agteo/diy-eeg-mac/Manufacturing/JLCPCB/BOM_JLCPCB_EEG.csv

Comment | Designator | Footprint | LCSC Part #
0.47uF 25V X7R 0603 | C1 | 0603 | C1623
4.7uF 25V X5R 0805 | C2,C3,C48 | 0805 | C1779
4.7uF 25V X5R 0805 | C49 | 0805 | C1779
2.2uF 25V X7R 0805 | C4,C5 | 0805 | C19110
10uF 25V X5R 0805 | C6,C7,C9,C12,C33 | 0805 | C15850
1uF 50V X5R 0603 | C10,C11,C35,C36,C38,C39,C40,C43,C44,C46 | 0603 | C15849
100nF 50V X7R 0603 | C13,C32,C37,C41,C42,C45,C47 | 0603 | C14663
1.5nF 50V C0G 5% 0603 | C14 | 0603 | C107039
1nF 50V C0G 1% 0603 | C15,C16,C17,C18,C19,C20,C21,C22,C23,C24,C25,C26,C27,C28,C29,C30,C31 | 0603 | C309468
100uF 6.3V X5R 1206 | C34 | 1206 | C15008
TPD4E1B06DCKR | D1,D2,D3,D4,D5 | SC-70-6 | C840093
SD05T1G | D6 | SOD-323 | C233423
ESD 5V uni TVS SOD-523 | D7 | SOD-523 | C136171
JST PH 2-pin side-entry | J1 | JST-PH-2P-RA-THT | C173752
USB-C receptacle USB2.0 16P | J2 | USB-C-SMD | C3197684
Pin header 1x2 2.54mm straight | J3A,J3B,J3C,J3D,J3E,J3F,J3G,J3H,J3I,J3J,JP1 | HDR-1x2-2.54-THT | C32713268
Pin header 1x3 2.54mm straight | J5 | HDR-1x3-2.54-THT | C6292175
130k 0.1% 25ppm thin film 0603 | R1 | 0603 | C855601
120k 0.1% 25ppm thin film 0603 | R2 | 0603 | C705720
105k 0.1% 25ppm thin film 0603 | R3 | 0603 | C861072
100k 0.1% 25ppm thin film 0603 | R4 | 0603 | C855559
5.1k 1% 0603 | R5,R6 | 0603 | C23186
10k 1% 0603 | R7,R8,R28,R29,R30,R31 | 0603 | C25804
10k 1% 0603 | R32,R33,R34,R35 | 0603 | C25804
1M 1% 0603 | R9 | 0603 | C22935
2.2k 0.1% 25ppm thin film 0603 | R10,R11,R12,R13,R14,R15,R16,R17,R18,R19,R20,R21,R22,R23,R24,R25,R26,R27 | 0603 | C861295
Slide switch SPDT | SW1 | C&K-1101M2S3CQE2-THT | C221538
Tactile switch 4.5mm SMD J-lead | SW2,SW3 | Bourns-7914J | C913243
Test point orange THT | TP1 | Keystone-5003-THT | C238124
LM27762DSSR | U1 | WSON-12-EP(2x3) | C473398
TLV75733PDBVR | U2 | SOT-23-5 | C485517
TPS7A2033PDBVR | U3 | SOT-23-5 | C2862740
ADS1299IPAGR | U4 | TQFP-64(10x10) | C476817
ESP32-S3-WROOM-1-N8R8 | U5 | ESP32-S3-WROOM-1 | C2913201
