agteo/diy-eeg-mac/Hardware/Enclosure_Inventor_Project/Enclosure_Top.stp

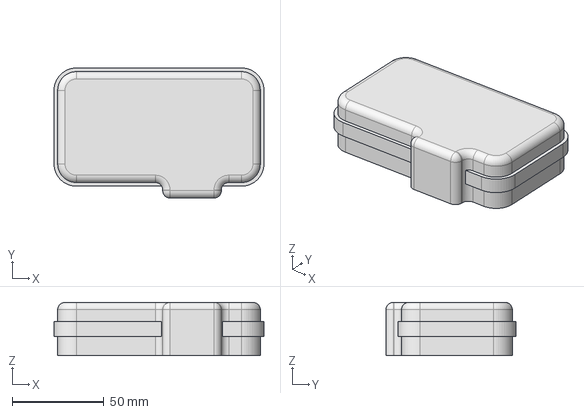
[picture p6: CAD file, 2026-10-10]
Hardware/Enclosure_Inventor_Project/Enclosure_Top.stp
114.4 x 70.9 x 29.0 mm
