agteo/diy-eeg-mac/Production_Files/Enclosure STL Files/Enclosure Bottom.stl

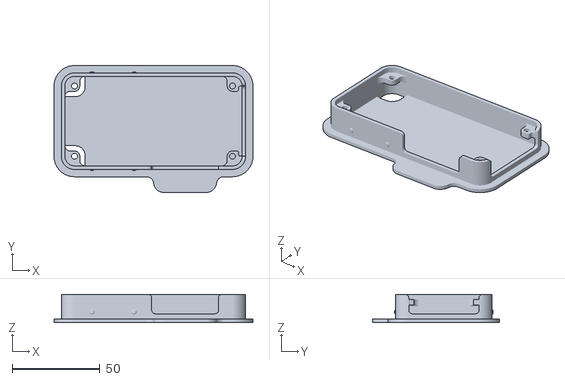
[picture p7: CAD file, 2026-10-10]
Production_Files/Enclosure STL Files/Enclosure Bottom.stl
113.4 x 72.4 x 16.0
