agteo/diy-eeg-mac/(list of files, cad)

Other CAD files:
Hardware/Enclosure_Inventor_Project/Enclosure Bottom.stp
Production_Files/Enclosure STL Files/Enclosure_Top.stl
Hardware/Enclosure_Inventor_Project/Enclosure Bottom.ipt
Hardware/Enclosure_Inventor_Project/Enclosure_Multibody.ipt
Hardware/Enclosure_Inventor_Project/Enclosure_Top.ipt
Hardware/Enclosure_Inventor_Project/OldVersions/Enclosure Bottom.0002.ipt
Hardware/Enclosure_Inventor_Project/OldVersions/Enclosure_Top.0003.ipt
