agteo/diy-eeg-mac/(list of files, drawings)

Other design files:
Hardware/PCB_Altium_Project/Component Libraries/ESP32-S3-WROOM-1-N8R8/ESP32-S3-WROOM-1-N8R8.SchLib
Hardware/PCB_Altium_Project/Component Libraries/ESP32-S3-WROOM-1-N8R8/XCVR_ESP32S3WROOM1N8R8.PcbLib
Hardware/PCB_Altium_Project/DIY-EEG.PrjPcb
Hardware/PCB_Altium_Project/EEG_PCB.PcbDoc
Hardware/PCB_Altium_Project/EEG_Schematic.SchDoc
Hardware/PCB_Altium_Project/Low_Cost_EEG.PrjPcb
