agteo/diy-eeg-mac/(commit log)

2026-10-10 Add upstream hardware and macOS integration guides
    [ADS ESP EEG.GBL, ADS ESP EEG.GBO, ADS ESP EEG.GBP, ADS ESP EEG.GBS, ADS ESP EEG.GM1, ADS ESP EEG.GTL, ADS ESP EEG.GTO, ADS ESP EEG.GTP]
2026-10-10 Add JLCPCB bare board fabrication package
2026-10-10 Replace fabrication ZIP with drill-aligned package
2026-10-10 Add matching JLCPCB BOM and CPL
    [BOM_JLCPCB_EEG.csv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]
2026-10-11 Remove personal name from PCB silkscreen
    [ADS ESP EEG.GBO]
2026-10-11 Remove remaining back silkscreen labels
    [ADS ESP EEG.GBO]
2026-10-31 Manufacturing/JLCPCB: restore bottom silkscreen, add JLCPCB order notes and checks
    [placement_reference.csv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]
2026-10-31 Repo maintenance
    [Bill of Materials-EEG_BoM.xlsx, DIY-EEG.PrjPcb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]
2026-11-01 Save each Berger session and document how to run it.
    The alpha command writes the XDF and a channel-0 summary itself, and the summary uses the recording duration as the sample rate so the printed levels stay in microvolts.
2026-11-04 Add diy-eeg-alpha-spectrum: eyes-open vs eyes-closed power spectrum plot
    Saves a PNG of one channel's Welch spectrum for the eyes-open phases
    (averaged) and the eyes-closed phase, with the alpha band shaded and the
    eyes-closed peak marked. Reuses the phase windows and sample-rate logic
    from diy-eeg-alpha, and refuses flat (unconnected) channels.
2026-11-05 Separate missing samples from notification arrival spacing.
    A frame-sequence gap is counted as samples that never arrived. Host arrival spacing stays a separate check, including the 256-sample wrap limit.
2026-11-06 Record Fz as channel 4 on the daily montage.
    The questionnaire and the saved summary now name that electrode. Alpha scoring is unchanged.
2026-11-06 Add an HTML review of the daily Berger and Fz focus ratios.
    Each serial-7 run stores the 4–8 Hz ratio, and an older index gains that column when it is read.
2026-11-07 Add a shareable focus report and a location-based mains notch.
    The sample page shows focus, engagement, and theta/beta with made-up ratios and no waveform. After a sitting, the chosen location sets a 50 Hz or 60 Hz notch for scores and drawings, and the saved recording stays unfiltered.
